cameronus/ledcube/panel/3d/SOT883.step

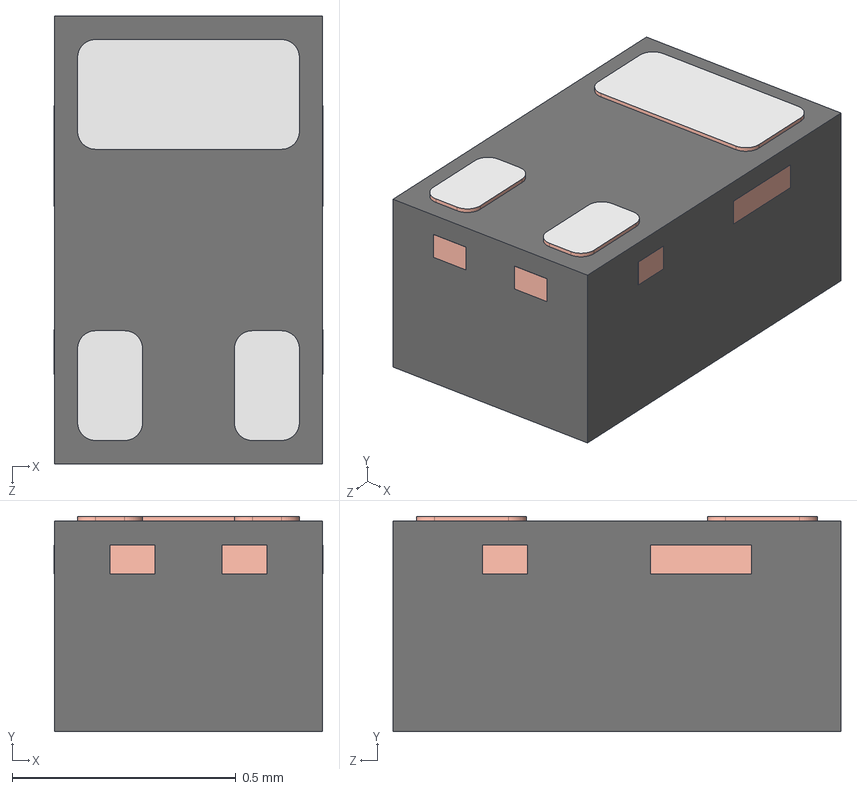
[picture p1: CAD file, 2021-07-28]
panel/3d/SOT883.step
0.6 x 0.48 x 1 mm
SOT883A2 LF
SOT883 Mold body
