cameronus/ledcube/panel/3d/MHPA1515RGBDT.step

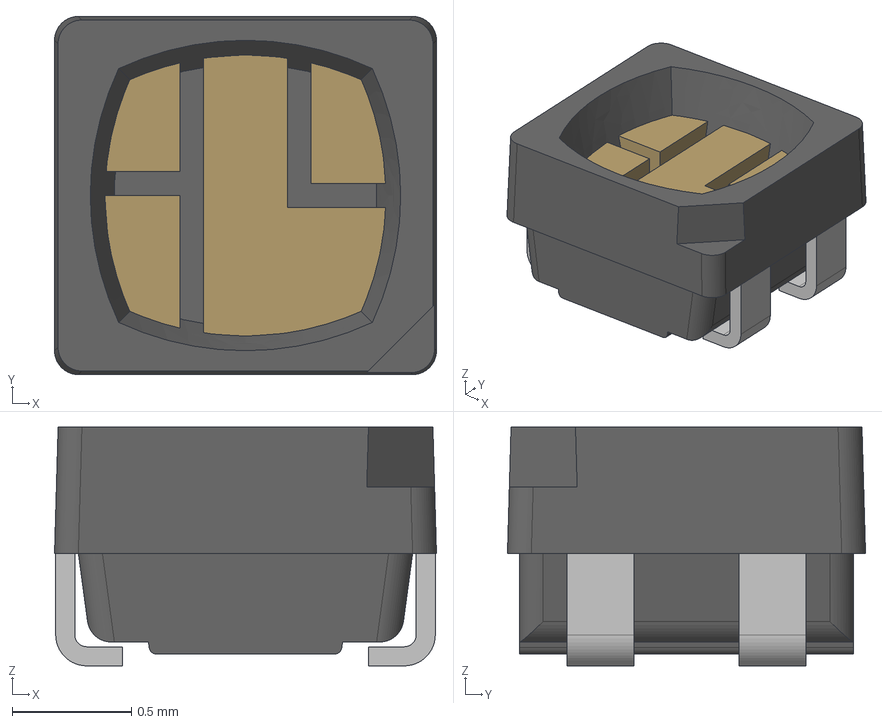
[picture p2: CAD file, 2021-07-22]
panel/3d/MHPA1515RGBDT.step
1.60 x 1.50 x 1.00 mm
Leads
Die
