cameronus/ledcube/panel/3d/5034800600.step

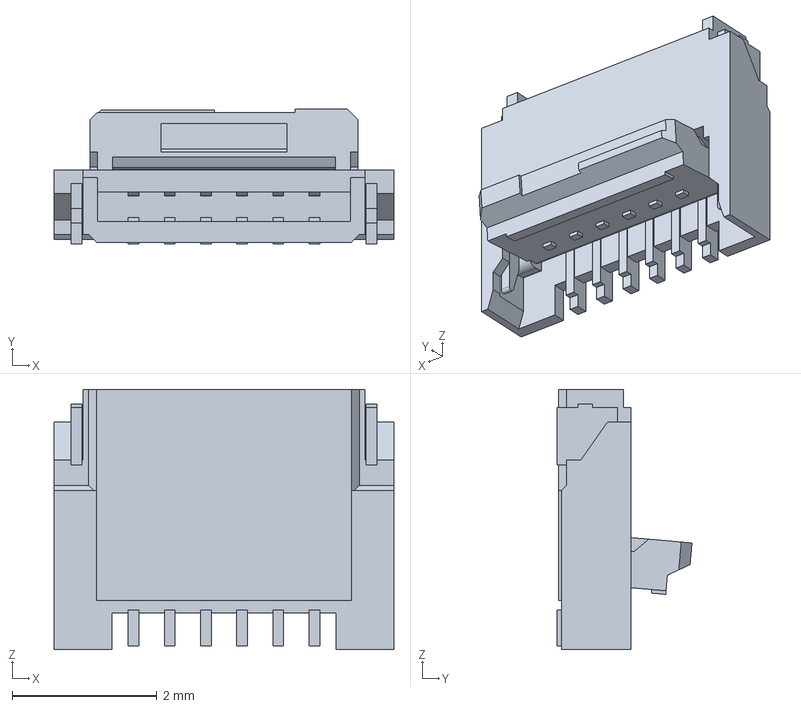
[picture p3: CAD file, 2021-07-28]
panel/3d/5034800600.step
4.70 x 1.87 x 3.60 mm
