cameronus/ledcube/panel/panel.kicad_pcb

## KiCad design panel/panel.kicad_pcb (2021-07-28)

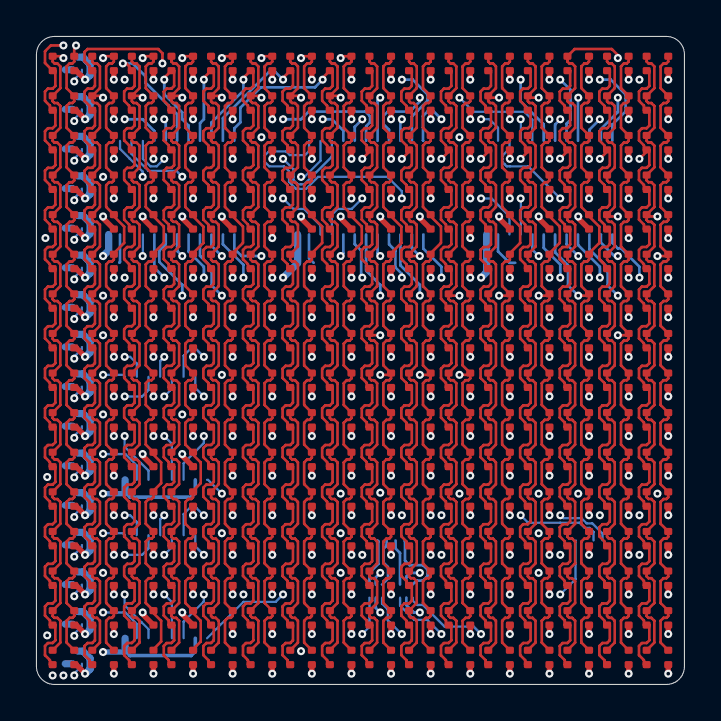
[picture p4: board panel.kicad_pcb from above]

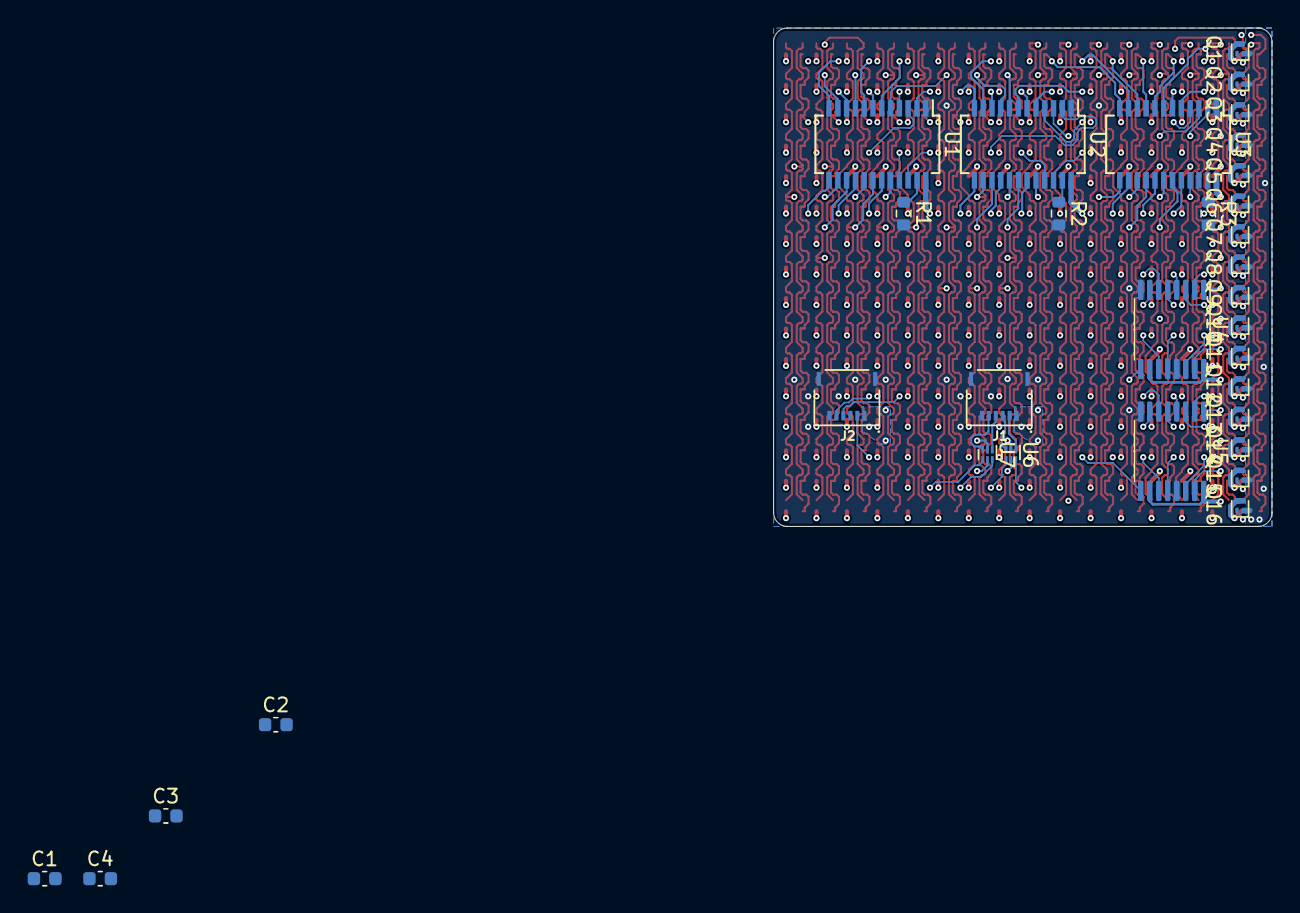
[picture p5: board panel.kicad_pcb from below]

Board: 4 copper layers, 36.0 x 36.0 mm, 288 parts (32 on the bottom side), 98 nets.

Parts:
C1, C2, C3, C4: 0.1uF; C_0603_1608Metric
D1, D2, D3, D4, D5, D6, D7, D8, D9, D10, D11, D12, D13, D14, D15, D16, D17, D18, D19, D20, D21, D22, D23, D24, D25, D26, D27, D28, D29, D30, D31, D32, D33, D34, D35, D36, D37, D38, D39, D40, D41, D42, D43, D44, D45, D46, D47, D48, D49, D50, D51, D52, D53, D54, D55, D56, D57, D58, D59, D60, D61, D62, D63, D64, D65, D66, D67, D68, D69, D70, D71, D72, D73, D74, D75, D76, D77, D78, D79, D80, D81, D82, D83, D84, D85, D86, D87, D88, D89, D90, D91, D92, D93, D94, D95, D96, D97, D98, D99, D100, D101, D102, D103, D104, D105, D106, D107, D108, D109, D110, D111, D112, D113, D114, D115, D116, D117, D118, D119, D120, D121, D122, D123, D124, D125, D126, D127, D128, D129, D130, D131, D132, D133, D134, D135, D136, D137, D138, D139, D140, D141, D142, D143, D144, D145, D146, D147, D148, D149, D150, D151, D152, D153, D154, D155, D156, D157, D158, D159, D160, D161, D162, D163, D164, D165, D166, D167, D168, D169, D170, D171, D172, D173, D174, D175, D176, D177, D178, D179, D180, D181, D182, D183, D184, D185, D186, D187, D188, D189, D190, D191, D192, D193, D194, D195, D196, D197, D198, D199, D200, D201, D202, D203, D204, D205, D206, D207, D208, D209, D210, D211, D212, D213, D214, D215, D216, D217, D218, D219, D220, D221, D222, D223, D224, D225, D226, D227, D228, D229, D230, D231, D232, D233, D234, D235, D236, D237, D238, D239, D240, D241, D242, D243, D244, D245, D246, D247, D248, D249, D250, D251, D252, D253, D254, D255, D256: LED_RABG; MHPA1515RGBDT
J1: IN; 5034800600
J2: OUT; 5034800600
Q1, Q2, Q3, Q4, Q5, Q6, Q7, Q8, Q9, Q10, Q11, Q12, Q13, Q14, Q15, Q16: Q_PMOS_GSD; SOT-883
R1: 2.2k; R_0603_1608Metric
R2: 7.5k; R_0603_1608Metric
R3: 4.12k; R_0603_1608Metric
U1, U2, U3: TLC59025; SSOP-24_3.9x8.7mm_P0.635mm
U4, U5: SN74HC595; TSSOP-16_4.4x5mm_P0.65mm
U6, U7: NC7WZ17; Fairchild_MicroPak2-6_1.0x1.0mm_P0.35mm

Connections:
/BLANK: J2.5, U1.21 (~OE), U2.21 (~OE), U3.21 (~OE), U7.4 (Y2)
/BLANK_IN: J1.5, U7.3 (A2)
/CLK: J2.2, U1.3 (CLK), U2.3 (CLK), U3.3 (CLK), U4.11 (SRCLK), U5.11 (SRCLK), U6.6 (Y1)
/CLK_IN: J1.2, U6.1 (A1)
/DAT: U4.14 (SER), U6.4 (Y2)
/DAT2: U4.9 (QH'), U5.14 (SER)
/DAT3: U1.2 (SDI), U5.9 (QH')
/DAT4: U1.22 (SDO), U2.2 (SDI)
/DAT5: U2.22 (SDO), U3.2 (SDI)
/DAT_IN: J1.3, U6.3 (A2)
/DAT_OUT: J2.3, U3.22 (SDO)
/LATCH: J2.4, U1.4 (LE), U2.4 (LE), U3.4 (LE), U4.12 (RCLK), U5.12 (RCLK), U7.6 (Y1)
/LATCH_IN: J1.4, U7.1 (A1)
/ROW_0: Q1.1 (G), U4.15 (QA)
/ROW_0/COMMON: D1.2 (A), D2.2 (A), D3.2 (A), D4.2 (A), D5.2 (A), D6.2 (A), D7.2 (A), D8.2 (A), D9.2 (A), D10.2 (A), D11.2 (A), D12.2 (A), D13.2 (A), D14.2 (A), D15.2 (A), D16.2 (A), Q1.3 (D)
/ROW_1: Q2.1 (G), U4.1 (QB)
/ROW_1/COMMON: D17.2 (A), D18.2 (A), D19.2 (A), D20.2 (A), D21.2 (A), D22.2 (A), D23.2 (A), D24.2 (A), D25.2 (A), D26.2 (A), D27.2 (A), D28.2 (A), D29.2 (A), D30.2 (A), D31.2 (A), D32.2 (A), Q2.3 (D)
/ROW_2: Q3.1 (G), U4.2 (QC)
/ROW_2/COMMON: D33.2 (A), D34.2 (A), D35.2 (A), D36.2 (A), D37.2 (A), D38.2 (A), D39.2 (A), D40.2 (A), D41.2 (A), D42.2 (A), D43.2 (A), D44.2 (A), D45.2 (A), D46.2 (A), D47.2 (A), D48.2 (A), Q3.3 (D)
/ROW_3: Q4.1 (G), U4.3 (QD)
/ROW_3/COMMON: D49.2 (A), D50.2 (A), D51.2 (A), D52.2 (A), D53.2 (A), D54.2 (A), D55.2 (A), D56.2 (A), D57.2 (A), D58.2 (A), D59.2 (A), D60.2 (A), D61.2 (A), D62.2 (A), D63.2 (A), D64.2 (A), Q4.3 (D)
/ROW_4: Q5.1 (G), U4.4 (QE)
/ROW_4/COMMON: D65.2 (A), D66.2 (A), D67.2 (A), D68.2 (A), D69.2 (A), D70.2 (A), D71.2 (A), D72.2 (A), D73.2 (A), D74.2 (A), D75.2 (A), D76.2 (A), D77.2 (A), D78.2 (A), D79.2 (A), D80.2 (A), Q5.3 (D)
/ROW_5: Q6.1 (G), U4.5 (QF)
/ROW_5/COMMON: D81.2 (A), D82.2 (A), D83.2 (A), D84.2 (A), D85.2 (A), D86.2 (A), D87.2 (A), D88.2 (A), D89.2 (A), D90.2 (A), D91.2 (A), D92.2 (A), D93.2 (A), D94.2 (A), D95.2 (A), D96.2 (A), Q6.3 (D)
/ROW_6: Q7.1 (G), U4.6 (QG)
/ROW_6/COMMON: D97.2 (A), D98.2 (A), D99.2 (A), D100.2 (A), D101.2 (A), D102.2 (A), D103.2 (A), D104.2 (A), D105.2 (A), D106.2 (A), D107.2 (A), D108.2 (A), D109.2 (A), D110.2 (A), D111.2 (A), D112.2 (A), Q7.3 (D)
/ROW_7: Q8.1 (G), U4.7 (QH)
/ROW_7/COMMON: D113.2 (A), D114.2 (A), D115.2 (A), D116.2 (A), D117.2 (A), D118.2 (A), D119.2 (A), D120.2 (A), D121.2 (A), D122.2 (A), D123.2 (A), D124.2 (A), D125.2 (A), D126.2 (A), D127.2 (A), D128.2 (A), Q8.3 (D)
/ROW_8: Q9.1 (G), U5.15 (QA)
/ROW_8/COMMON: D129.2 (A), D130.2 (A), D131.2 (A), D132.2 (A), D133.2 (A), D134.2 (A), D135.2 (A), D136.2 (A), D137.2 (A), D138.2 (A), D139.2 (A), D140.2 (A), D141.2 (A), D142.2 (A), D143.2 (A), D144.2 (A), Q9.3 (D)
/ROW_9: Q10.1 (G), U5.1 (QB)
/ROW_9/COMMON: D145.2 (A), D146.2 (A), D147.2 (A), D148.2 (A), D149.2 (A), D150.2 (A), D151.2 (A), D152.2 (A), D153.2 (A), D154.2 (A), D155.2 (A), D156.2 (A), D157.2 (A), D158.2 (A), D159.2 (A), D160.2 (A), Q10.3 (D)
/ROW_10: Q11.1 (G), U5.2 (QC)
/ROW_10/COMMON: D161.2 (A), D162.2 (A), D163.2 (A), D164.2 (A), D165.2 (A), D166.2 (A), D167.2 (A), D168.2 (A), D169.2 (A), D170.2 (A), D171.2 (A), D172.2 (A), D173.2 (A), D174.2 (A), D175.2 (A), D176.2 (A), Q11.3 (D)
/ROW_11: Q12.1 (G), U5.3 (QD)
/ROW_11/COMMON: D177.2 (A), D178.2 (A), D179.2 (A), D180.2 (A), D181.2 (A), D182.2 (A), D183.2 (A), D184.2 (A), D185.2 (A), D186.2 (A), D187.2 (A), D188.2 (A), D189.2 (A), D190.2 (A), D191.2 (A), D192.2 (A), Q12.3 (D)
/ROW_12: Q13.1 (G), U5.4 (QE)
/ROW_12/COMMON: D193.2 (A), D194.2 (A), D195.2 (A), D196.2 (A), D197.2 (A), D198.2 (A), D199.2 (A), D200.2 (A), D201.2 (A), D202.2 (A), D203.2 (A), D204.2 (A), D205.2 (A), D206.2 (A), D207.2 (A), D208.2 (A), Q13.3 (D)
/ROW_13: Q14.1 (G), U5.5 (QF)
/ROW_13/COMMON: D209.2 (A), D210.2 (A), D211.2 (A), D212.2 (A), D213.2 (A), D214.2 (A), D215.2 (A), D216.2 (A), D217.2 (A), D218.2 (A), D219.2 (A), D220.2 (A), D221.2 (A), D222.2 (A), D223.2 (A), D224.2 (A), Q14.3 (D)
/ROW_14: Q15.1 (G), U5.6 (QG)
/ROW_14/COMMON: D225.2 (A), D226.2 (A), D227.2 (A), D228.2 (A), D229.2 (A), D230.2 (A), D231.2 (A), D232.2 (A), D233.2 (A), D234.2 (A), D235.2 (A), D236.2 (A), D237.2 (A), D238.2 (A), D239.2 (A), D240.2 (A), Q15.3 (D)
/ROW_15: Q16.1 (G), U5.7 (QH)
/ROW_15/COMMON: D241.2 (A), D242.2 (A), D243.2 (A), D244.2 (A), D245.2 (A), D246.2 (A), D247.2 (A), D248.2 (A), D249.2 (A), D250.2 (A), D251.2 (A), D252.2 (A), D253.2 (A), D254.2 (A), D255.2 (A), D256.2 (A), Q16.3 (D)
COL_0B: D1.3 (BK), D17.3 (BK), D33.3 (BK), D49.3 (BK), D65.3 (BK), D81.3 (BK), D97.3 (BK), D113.3 (BK), D129.3 (BK), D145.3 (BK), D161.3 (BK), D177.3 (BK), D193.3 (BK), D209.3 (BK), D225.3 (BK), D241.3 (BK), U3.5 (~OUT0)
COL_0G: D1.4 (GK), D17.4 (GK), D33.4 (GK), D49.4 (GK), D65.4 (GK), D81.4 (GK), D97.4 (GK), D113.4 (GK), D129.4 (GK), D145.4 (GK), D161.4 (GK), D177.4 (GK), D193.4 (GK), D209.4 (GK), D225.4 (GK), D241.4 (GK), U2.5 (~OUT0)
COL_0R: D1.1 (RK), D17.1 (RK), D33.1 (RK), D49.1 (RK), D65.1 (RK), D81.1 (RK), D97.1 (RK), D113.1 (RK), D129.1 (RK), D145.1 (RK), D161.1 (RK), D177.1 (RK), D193.1 (RK), D209.1 (RK), D225.1 (RK), D241.1 (RK), U1.5 (~OUT0)
COL_1B: D2.3 (BK), D18.3 (BK), D34.3 (BK), D50.3 (BK), D66.3 (BK), D82.3 (BK), D98.3 (BK), D114.3 (BK), D130.3 (BK), D146.3 (BK), D162.3 (BK), D178.3 (BK), D194.3 (BK), D210.3 (BK), D226.3 (BK), D242.3 (BK), U3.6 (~OUT1)
COL_1G: D2.4 (GK), D18.4 (GK), D34.4 (GK), D50.4 (GK), D66.4 (GK), D82.4 (GK), D98.4 (GK), D114.4 (GK), D130.4 (GK), D146.4 (GK), D162.4 (GK), D178.4 (GK), D194.4 (GK), D210.4 (GK), D226.4 (GK), D242.4 (GK), U2.6 (~OUT1)
COL_1R: D2.1 (RK), D18.1 (RK), D34.1 (RK), D50.1 (RK), D66.1 (RK), D82.1 (RK), D98.1 (RK), D114.1 (RK), D130.1 (RK), D146.1 (RK), D162.1 (RK), D178.1 (RK), D194.1 (RK), D210.1 (RK), D226.1 (RK), D242.1 (RK), U1.6 (~OUT1)
COL_2B: D3.3 (BK), D19.3 (BK), D35.3 (BK), D51.3 (BK), D67.3 (BK), D83.3 (BK), D99.3 (BK), D115.3 (BK), D131.3 (BK), D147.3 (BK), D163.3 (BK), D179.3 (BK), D195.3 (BK), D211.3 (BK), D227.3 (BK), D243.3 (BK), U3.7 (~OUT2)
COL_2G: D3.4 (GK), D19.4 (GK), D35.4 (GK), D51.4 (GK), D67.4 (GK), D83.4 (GK), D99.4 (GK), D115.4 (GK), D131.4 (GK), D147.4 (GK), D163.4 (GK), D179.4 (GK), D195.4 (GK), D211.4 (GK), D227.4 (GK), D243.4 (GK), U2.7 (~OUT2)
COL_2R: D3.1 (RK), D19.1 (RK), D35.1 (RK), D51.1 (RK), D67.1 (RK), D83.1 (RK), D99.1 (RK), D115.1 (RK), D131.1 (RK), D147.1 (RK), D163.1 (RK), D179.1 (RK), D195.1 (RK), D211.1 (RK), D227.1 (RK), D243.1 (RK), U1.7 (~OUT2)
COL_3B: D4.3 (BK), D20.3 (BK), D36.3 (BK), D52.3 (BK), D68.3 (BK), D84.3 (BK), D100.3 (BK), D116.3 (BK), D132.3 (BK), D148.3 (BK), D164.3 (BK), D180.3 (BK), D196.3 (BK), D212.3 (BK), D228.3 (BK), D244.3 (BK), U3.8 (~OUT3)
COL_3G: D4.4 (GK), D20.4 (GK), D36.4 (GK), D52.4 (GK), D68.4 (GK), D84.4 (GK), D100.4 (GK), D116.4 (GK), D132.4 (GK), D148.4 (GK), D164.4 (GK), D180.4 (GK), D196.4 (GK), D212.4 (GK), D228.4 (GK), D244.4 (GK), U2.8 (~OUT3)
COL_3R: D4.1 (RK), D20.1 (RK), D36.1 (RK), D52.1 (RK), D68.1 (RK), D84.1 (RK), D100.1 (RK), D116.1 (RK), D132.1 (RK), D148.1 (RK), D164.1 (RK), D180.1 (RK), D196.1 (RK), D212.1 (RK), D228.1 (RK), D244.1 (RK), U1.8 (~OUT3)
COL_4B: D5.3 (BK), D21.3 (BK), D37.3 (BK), D53.3 (BK), D69.3 (BK), D85.3 (BK), D101.3 (BK), D117.3 (BK), D133.3 (BK), D149.3 (BK), D165.3 (BK), D181.3 (BK), D197.3 (BK), D213.3 (BK), D229.3 (BK), D245.3 (BK), U3.9 (~OUT4)
COL_4G: D5.4 (GK), D21.4 (GK), D37.4 (GK), D53.4 (GK), D69.4 (GK), D85.4 (GK), D101.4 (GK), D117.4 (GK), D133.4 (GK), D149.4 (GK), D165.4 (GK), D181.4 (GK), D197.4 (GK), D213.4 (GK), D229.4 (GK), D245.4 (GK), U2.9 (~OUT4)
COL_4R: D5.1 (RK), D21.1 (RK), D37.1 (RK), D53.1 (RK), D69.1 (RK), D85.1 (RK), D101.1 (RK), D117.1 (RK), D133.1 (RK), D149.1 (RK), D165.1 (RK), D181.1 (RK), D197.1 (RK), D213.1 (RK), D229.1 (RK), D245.1 (RK), U1.9 (~OUT4)
COL_5B: D6.3 (BK), D22.3 (BK), D38.3 (BK), D54.3 (BK), D70.3 (BK), D86.3 (BK), D102.3 (BK), D118.3 (BK), D134.3 (BK), D150.3 (BK), D166.3 (BK), D182.3 (BK), D198.3 (BK), D214.3 (BK), D230.3 (BK), D246.3 (BK), U3.10 (~OUT5)
COL_5G: D6.4 (GK), D22.4 (GK), D38.4 (GK), D54.4 (GK), D70.4 (GK), D86.4 (GK), D102.4 (GK), D118.4 (GK), D134.4 (GK), D150.4 (GK), D166.4 (GK), D182.4 (GK), D198.4 (GK), D214.4 (GK), D230.4 (GK), D246.4 (GK), U2.10 (~OUT5)
COL_5R: D6.1 (RK), D22.1 (RK), D38.1 (RK), D54.1 (RK), D70.1 (RK), D86.1 (RK), D102.1 (RK), D118.1 (RK), D134.1 (RK), D150.1 (RK), D166.1 (RK), D182.1 (RK), D198.1 (RK), D214.1 (RK), D230.1 (RK), D246.1 (RK), U1.10 (~OUT5)
COL_6B: D7.3 (BK), D23.3 (BK), D39.3 (BK), D55.3 (BK), D71.3 (BK), D87.3 (BK), D103.3 (BK), D119.3 (BK), D135.3 (BK), D151.3 (BK), D167.3 (BK), D183.3 (BK), D199.3 (BK), D215.3 (BK), D231.3 (BK), D247.3 (BK), U3.11 (~OUT6)
COL_6G: D7.4 (GK), D23.4 (GK), D39.4 (GK), D55.4 (GK), D71.4 (GK), D87.4 (GK), D103.4 (GK), D119.4 (GK), D135.4 (GK), D151.4 (GK), D167.4 (GK), D183.4 (GK), D199.4 (GK), D215.4 (GK), D231.4 (GK), D247.4 (GK), U2.11 (~OUT6)
COL_6R: D7.1 (RK), D23.1 (RK), D39.1 (RK), D55.1 (RK), D71.1 (RK), D87.1 (RK), D103.1 (RK), D119.1 (RK), D135.1 (RK), D151.1 (RK), D167.1 (RK), D183.1 (RK), D199.1 (RK), D215.1 (RK), D231.1 (RK), D247.1 (RK), U1.11 (~OUT6)
COL_7B: D8.3 (BK), D24.3 (BK), D40.3 (BK), D56.3 (BK), D72.3 (BK), D88.3 (BK), D104.3 (BK), D120.3 (BK), D136.3 (BK), D152.3 (BK), D168.3 (BK), D184.3 (BK), D200.3 (BK), D216.3 (BK), D232.3 (BK), D248.3 (BK), U3.12 (~OUT7)
COL_7G: D8.4 (GK), D24.4 (GK), D40.4 (GK), D56.4 (GK), D72.4 (GK), D88.4 (GK), D104.4 (GK), D120.4 (GK), D136.4 (GK), D152.4 (GK), D168.4 (GK), D184.4 (GK), D200.4 (GK), D216.4 (GK), D232.4 (GK), D248.4 (GK), U2.12 (~OUT7)
COL_7R: D8.1 (RK), D24.1 (RK), D40.1 (RK), D56.1 (RK), D72.1 (RK), D88.1 (RK), D104.1 (RK), D120.1 (RK), D136.1 (RK), D152.1 (RK), D168.1 (RK), D184.1 (RK), D200.1 (RK), D216.1 (RK), D232.1 (RK), D248.1 (RK), U1.12 (~OUT7)
COL_8B: D9.3 (BK), D25.3 (BK), D41.3 (BK), D57.3 (BK), D73.3 (BK), D89.3 (BK), D105.3 (BK), D121.3 (BK), D137.3 (BK), D153.3 (BK), D169.3 (BK), D185.3 (BK), D201.3 (BK), D217.3 (BK), D233.3 (BK), D249.3 (BK), U3.13 (~OUT8)
COL_8G: D9.4 (GK), D25.4 (GK), D41.4 (GK), D57.4 (GK), D73.4 (GK), D89.4 (GK), D105.4 (GK), D121.4 (GK), D137.4 (GK), D153.4 (GK), D169.4 (GK), D185.4 (GK), D201.4 (GK), D217.4 (GK), D233.4 (GK), D249.4 (GK), U2.13 (~OUT8)
COL_8R: D9.1 (RK), D25.1 (RK), D41.1 (RK), D57.1 (RK), D73.1 (RK), D89.1 (RK), D105.1 (RK), D121.1 (RK), D137.1 (RK), D153.1 (RK), D169.1 (RK), D185.1 (RK), D201.1 (RK), D217.1 (RK), D233.1 (RK), D249.1 (RK), U1.13 (~OUT8)
COL_9B: D10.3 (BK), D26.3 (BK), D42.3 (BK), D58.3 (BK), D74.3 (BK), D90.3 (BK), D106.3 (BK), D122.3 (BK), D138.3 (BK), D154.3 (BK), D170.3 (BK), D186.3 (BK), D202.3 (BK), D218.3 (BK), D234.3 (BK), D250.3 (BK), U3.14 (~OUT9)
COL_9G: D10.4 (GK), D26.4 (GK), D42.4 (GK), D58.4 (GK), D74.4 (GK), D90.4 (GK), D106.4 (GK), D122.4 (GK), D138.4 (GK), D154.4 (GK), D170.4 (GK), D186.4 (GK), D202.4 (GK), D218.4 (GK), D234.4 (GK), D250.4 (GK), U2.14 (~OUT9)
COL_9R: D10.1 (RK), D26.1 (RK), D42.1 (RK), D58.1 (RK), D74.1 (RK), D90.1 (RK), D106.1 (RK), D122.1 (RK), D138.1 (RK), D154.1 (RK), D170.1 (RK), D186.1 (RK), D202.1 (RK), D218.1 (RK), D234.1 (RK), D250.1 (RK), U1.14 (~OUT9)
COL_10B: D11.3 (BK), D27.3 (BK), D43.3 (BK), D59.3 (BK), D75.3 (BK), D91.3 (BK), D107.3 (BK), D123.3 (BK), D139.3 (BK), D155.3 (BK), D171.3 (BK), D187.3 (BK), D203.3 (BK), D219.3 (BK), D235.3 (BK), D251.3 (BK), U3.15 (~OUT10)
COL_10G: D11.4 (GK), D27.4 (GK), D43.4 (GK), D59.4 (GK), D75.4 (GK), D91.4 (GK), D107.4 (GK), D123.4 (GK), D139.4 (GK), D155.4 (GK), D171.4 (GK), D187.4 (GK), D203.4 (GK), D219.4 (GK), D235.4 (GK), D251.4 (GK), U2.15 (~OUT10)
COL_10R: D11.1 (RK), D27.1 (RK), D43.1 (RK), D59.1 (RK), D75.1 (RK), D91.1 (RK), D107.1 (RK), D123.1 (RK), D139.1 (RK), D155.1 (RK), D171.1 (RK), D187.1 (RK), D203.1 (RK), D219.1 (RK), D235.1 (RK), D251.1 (RK), U1.15 (~OUT10)
COL_11B: D12.3 (BK), D28.3 (BK), D44.3 (BK), D60.3 (BK), D76.3 (BK), D92.3 (BK), D108.3 (BK), D124.3 (BK), D140.3 (BK), D156.3 (BK), D172.3 (BK), D188.3 (BK), D204.3 (BK), D220.3 (BK), D236.3 (BK), D252.3 (BK), U3.16 (~OUT11)
COL_11G: D12.4 (GK), D28.4 (GK), D44.4 (GK), D60.4 (GK), D76.4 (GK), D92.4 (GK), D108.4 (GK), D124.4 (GK), D140.4 (GK), D156.4 (GK), D172.4 (GK), D188.4 (GK), D204.4 (GK), D220.4 (GK), D236.4 (GK), D252.4 (GK), U2.16 (~OUT11)
COL_11R: D12.1 (RK), D28.1 (RK), D44.1 (RK), D60.1 (RK), D76.1 (RK), D92.1 (RK), D108.1 (RK), D124.1 (RK), D140.1 (RK), D156.1 (RK), D172.1 (RK), D188.1 (RK), D204.1 (RK), D220.1 (RK), D236.1 (RK), D252.1 (RK), U1.16 (~OUT11)
COL_12B: D13.3 (BK), D29.3 (BK), D45.3 (BK), D61.3 (BK), D77.3 (BK), D93.3 (BK), D109.3 (BK), D125.3 (BK), D141.3 (BK), D157.3 (BK), D173.3 (BK), D189.3 (BK), D205.3 (BK), D221.3 (BK), D237.3 (BK), D253.3 (BK), U3.17 (~OUT12)
COL_12G: D13.4 (GK), D29.4 (GK), D45.4 (GK), D61.4 (GK), D77.4 (GK), D93.4 (GK), D109.4 (GK), D125.4 (GK), D141.4 (GK), D157.4 (GK), D173.4 (GK), D189.4 (GK), D205.4 (GK), D221.4 (GK), D237.4 (GK), D253.4 (GK), U2.17 (~OUT12)
COL_12R: D13.1 (RK), D29.1 (RK), D45.1 (RK), D61.1 (RK), D77.1 (RK), D93.1 (RK), D109.1 (RK), D125.1 (RK), D141.1 (RK), D157.1 (RK), D173.1 (RK), D189.1 (RK), D205.1 (RK), D221.1 (RK), D237.1 (RK), D253.1 (RK), U1.17 (~OUT12)
COL_13B: D14.3 (BK), D30.3 (BK), D46.3 (BK), D62.3 (BK), D78.3 (BK), D94.3 (BK), D110.3 (BK), D126.3 (BK), D142.3 (BK), D158.3 (BK), D174.3 (BK), D190.3 (BK), D206.3 (BK), D222.3 (BK), D238.3 (BK), D254.3 (BK), U3.18 (~OUT13)
COL_13G: D14.4 (GK), D30.4 (GK), D46.4 (GK), D62.4 (GK), D78.4 (GK), D94.4 (GK), D110.4 (GK), D126.4 (GK), D142.4 (GK), D158.4 (GK), D174.4 (GK), D190.4 (GK), D206.4 (GK), D222.4 (GK), D238.4 (GK), D254.4 (GK), U2.18 (~OUT13)
COL_13R: D14.1 (RK), D30.1 (RK), D46.1 (RK), D62.1 (RK), D78.1 (RK), D94.1 (RK), D110.1 (RK), D126.1 (RK), D142.1 (RK), D158.1 (RK), D174.1 (RK), D190.1 (RK), D206.1 (RK), D222.1 (RK), D238.1 (RK), D254.1 (RK), U1.18 (~OUT13)
COL_14B: D15.3 (BK), D31.3 (BK), D47.3 (BK), D63.3 (BK), D79.3 (BK), D95.3 (BK), D111.3 (BK), D127.3 (BK), D143.3 (BK), D159.3 (BK), D175.3 (BK), D191.3 (BK), D207.3 (BK), D223.3 (BK), D239.3 (BK), D255.3 (BK), U3.19 (~OUT14)
COL_14G: D15.4 (GK), D31.4 (GK), D47.4 (GK), D63.4 (GK), D79.4 (GK), D95.4 (GK), D111.4 (GK), D127.4 (GK), D143.4 (GK), D159.4 (GK), D175.4 (GK), D191.4 (GK), D207.4 (GK), D223.4 (GK), D239.4 (GK), D255.4 (GK), U2.19 (~OUT14)
COL_14R: D15.1 (RK), D31.1 (RK), D47.1 (RK), D63.1 (RK), D79.1 (RK), D95.1 (RK), D111.1 (RK), D127.1 (RK), D143.1 (RK), D159.1 (RK), D175.1 (RK), D191.1 (RK), D207.1 (RK), D223.1 (RK), D239.1 (RK), D255.1 (RK), U1.19 (~OUT14)
COL_15B: D16.3 (BK), D32.3 (BK), D48.3 (BK), D64.3 (BK), D80.3 (BK), D96.3 (BK), D112.3 (BK), D128.3 (BK), D144.3 (BK), D160.3 (BK), D176.3 (BK), D192.3 (BK), D208.3 (BK), D224.3 (BK), D240.3 (BK), D256.3 (BK), U3.20 (~OUT15)
COL_15G: D16.4 (GK), D32.4 (GK), D48.4 (GK), D64.4 (GK), D80.4 (GK), D96.4 (GK), D112.4 (GK), D128.4 (GK), D144.4 (GK), D160.4 (GK), D176.4 (GK), D192.4 (GK), D208.4 (GK), D224.4 (GK), D240.4 (GK), D256.4 (GK), U2.20 (~OUT15)
COL_15R: D16.1 (RK), D32.1 (RK), D48.1 (RK), D64.1 (RK), D80.1 (RK), D96.1 (RK), D112.1 (RK), D128.1 (RK), D144.1 (RK), D160.1 (RK), D176.1 (RK), D192.1 (RK), D208.1 (RK), D224.1 (RK), D240.1 (RK), D256.1 (RK), U1.20 (~OUT15)
GND: C1.2, C2.2, C3.2, C4.2, J1.6, J1.SH (Shield), J2.6, J2.SH (Shield), R1.2, R2.2, R3.2, U1.1 (GND), U2.1 (GND), U3.1 (GND), U4.8 (GND), U4.13 (~OE), U5.8 (GND), U5.13 (~OE), U6.2 (GND), U7.2 (GND)
unnamed: R1.1, U1.23 (REXT)
unnamed: R2.1, U2.23 (REXT)
unnamed: R3.1, U3.23 (REXT)
VCC: C1.1, C2.1, C3.1, C4.1, J1.1, J2.1, Q1.2 (S), Q2.2 (S), Q3.2 (S), Q4.2 (S), Q5.2 (S), Q6.2 (S), Q7.2 (S), Q8.2 (S), Q9.2 (S), Q10.2 (S), Q11.2 (S), Q12.2 (S), Q13.2 (S), Q14.2 (S), Q15.2 (S), Q16.2 (S), U1.24 (VDD), U2.24 (VDD), U3.24 (VDD), U4.10 (~SRCLR), U4.16 (VCC), U5.10 (~SRCLR), U5.16 (VCC), U6.5 (VCC), U7.5 (VCC)
