cameronus/ledcube/(commit log)

2021-07-19 LED driver/shift register symbol, hierarchical row sheet
    [ledcube.kicad_pcb, ledcube.kicad_sch, row.kicad_sch]
2021-07-20 Row/column labels attached to shift registers/drivers
    [ledcube.kicad_sch, row.kicad_sch]
2021-07-21 PMOS drivers, buffers, and serial connections
    [ledcube.kicad_sch, row.kicad_sch]
2021-07-21 Connectors and decoupling caps
    [ledcube.kicad_sch]
2021-07-21 LED footprint
    [ledcube.kicad_sch, row.kicad_sch]
2021-07-21 Moving panel to subfolder
    [panel.kicad_pcb, panel.kicad_sch, row.kicad_sch]
2021-07-21 Annotated schematic
    [panel.kicad_sch, row.kicad_sch]
2021-07-22 LED matrix placement
    [panel.kicad_pcb, panel.kicad_sch, row.kicad_sch]
2021-07-22 Routed columns
    [panel.kicad_pcb]
2021-07-22 Routed rows
    [panel.kicad_pcb]
2021-07-22 Modified column routing
    [panel.kicad_pcb]
2021-07-22 Routing fixes and CC drivers placed
    [MHPA1515RGBDT.step, panel.kicad_pcb]
2021-07-23 Placed row driver MOSFETs
    [panel.kicad_pcb]
2021-07-23 VCC plane and row driver placement
    [panel.kicad_pcb]
2021-07-23 Routed rows around row driver pins
    [panel.kicad_pcb]
2021-07-24 First option for row MOSFET layout
    [panel.kicad_pcb]
2021-07-24 New strategy for powering rows
    [panel.kicad_pcb]
2021-07-24 Row gates 0-7 routed
    [panel.kicad_pcb]
2021-07-25 Rerouted first half of row drivers
    [panel.kicad_pcb]
2021-07-25 Routed second half of row drivers
    [panel.kicad_pcb]
2021-07-26 Routed first 8 columns of blue and green channels
    [panel.kicad_pcb]
2021-07-26 Modified copper pours
    [panel.kicad_pcb]
2021-07-26 Columns 0-7 of R/G/B channels fully routed
    [panel.kicad_pcb]
2021-07-26 Routed columns 7-15 of blue channel
    [panel.kicad_pcb]
2021-07-26 Routed columns 7-15 of green channel
    [panel.kicad_pcb]
2021-07-26 Routed all R/G/B columns
    [panel.kicad_pcb]
2021-07-27 Working on routing serial signals
    [panel.kicad_pcb]
2021-07-28 More signal routing
    [panel.kicad_pcb]
2021-07-28 Placed connectors and routed buffers
    [5034800600.stp, SOT883.step, panel.kicad_pcb]
2021-07-28 Routed all data signals
    [panel.kicad_sch, row.kicad_sch]
2021-07-28 Placed decoupling caps
    [panel.kicad_sch]
2021-07-28 Finished routing and adding ground vias
2021-07-29 Silkscreen cleanup
    [panel.kicad_sch]
2021-07-29 More touchups
    [5034800600.step]
2021-07-30 Shrunk board width
2021-08-08 Silkscreen art and production files
    [panel-B_Cu.gbl, panel-B_Mask.gbs, panel-B_Paste.gbp, panel-B_Silkscreen.gbo, panel-Edge_Cuts.gm1, panel-F_Cu.gtl, panel-F_Mask.gts, panel-F_Paste.gtp]
2021-11-28 Breakout PCB
    [breakout-B_Cu.gbl, breakout-B_Mask.gbs, breakout-B_Silkscreen.gbo, breakout-Edge_Cuts.gm1, breakout-F_Cu.gtl, breakout-F_Mask.gts, breakout-F_Silkscreen.gto, breakout-NPTH.drl]
